MUDAL/Simple_Handwashing_System_With_STM32/Image.jpg

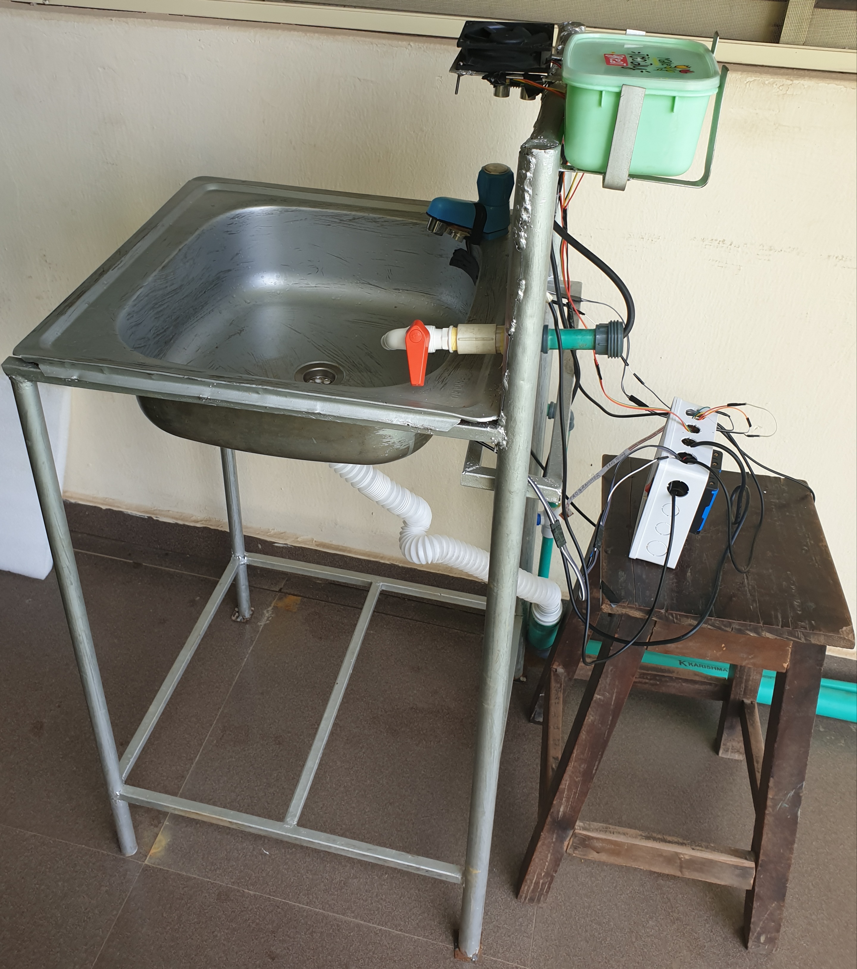
Image.jpg
