MUDAL/Simple_Handwashing_System_With_STM32/AHS Flowchart.pdf

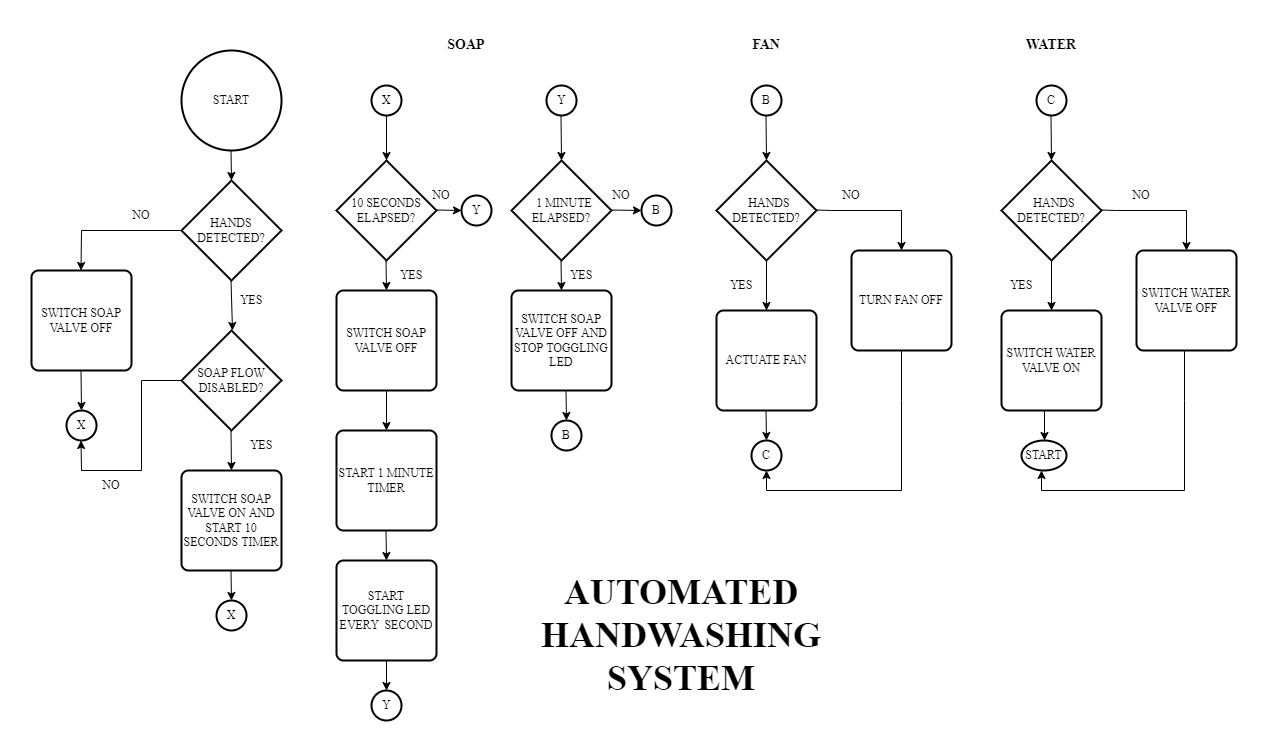
[picture p2: page 1]
