MUDAL/Simple_Handwashing_System_With_STM32/AHS Schematic.pdf

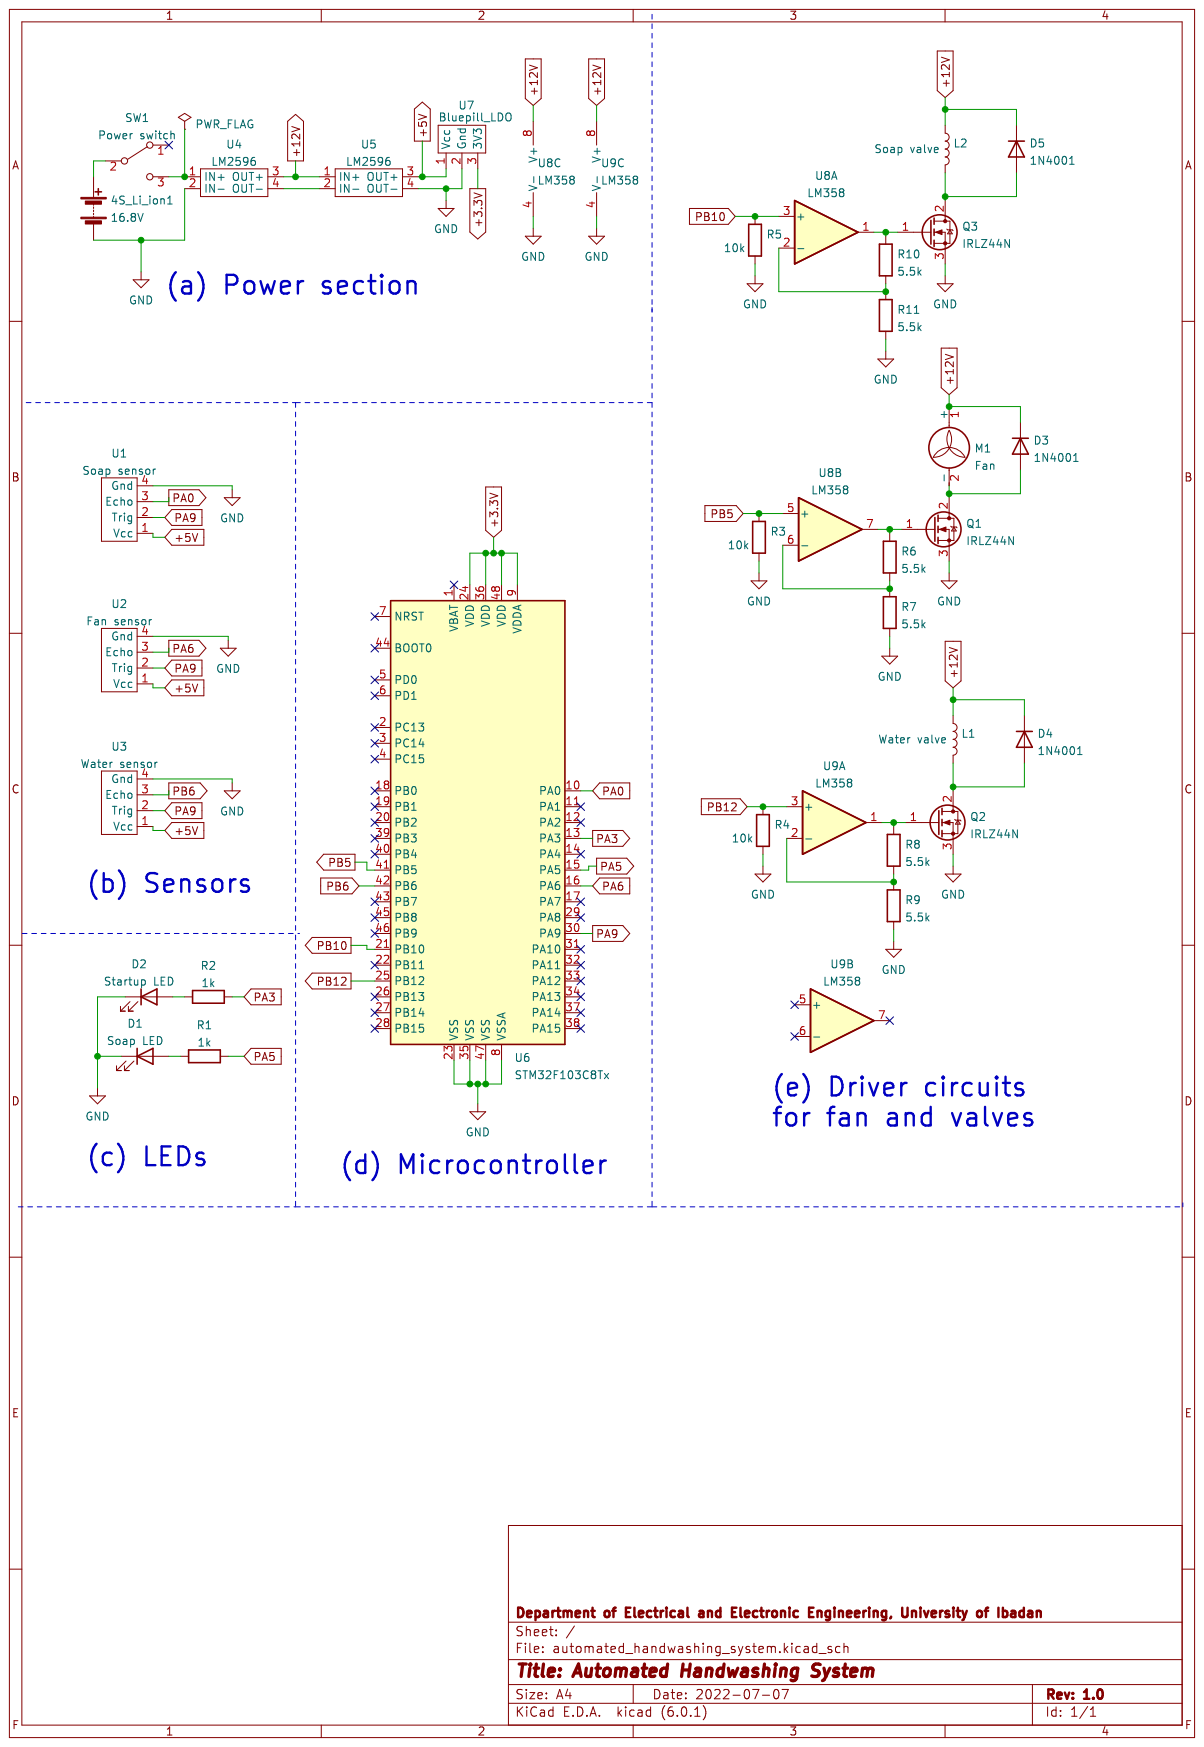
[picture p3: page 1]
