MUDAL/Simple_Handwashing_System_With_STM32/Source Code/Automated_Handwashing_System/Core/Src/main.c

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
/* Includes ------------------------------------------------------------------*/
#include "main.h"

/* USER CODE BEGIN Includes */
#include <stdbool.h>
#include "stm32f1xx_it.h"
/**
 * Important note
 * Timer 1 for all sensors (trigger pin)
 * Timer 2 for soap sensor
 * Timer 3 for fan sensor
 * Timer 4 for water sensor
 *
 * */

/* USER CODE END Includes */

/* USER CODE BEGIN PM */
//Equation: distance = pulse_width * echo_prescaler / (clkMHz * 58)
#define MAX_PULSE_WIDTH	 40 //8.6cm
/* USER CODE END PM */

 TIM_HandleTypeDef htim1;
TIM_HandleTypeDef htim2;
TIM_HandleTypeDef htim3;
TIM_HandleTypeDef htim4;

void SystemClock_Config(void);
static void MX_GPIO_Init(void);
static void MX_TIM1_Init(void);
static void MX_TIM2_Init(void);
static void MX_TIM3_Init(void);
static void MX_TIM4_Init(void);
/* USER CODE BEGIN 0 */
bool HandsDetected(TIM_HandleTypeDef* htim)
{
	uint32_t pulseWidth = 0;
	if((htim->Instance->SR & TIM_SR_CC2IF) == TIM_SR_CC2IF)
	{
		pulseWidth = htim->Instance->CCR2;
	}
	if(pulseWidth < MAX_PULSE_WIDTH)
	{
		return true;
	}
	return false;
}

/* USER CODE END 0 */

/**
  * @brief  The application entry point.
  * @retval int
  */
int main(void)
{
  /* USER CODE BEGIN 1 */
  //Variable(s)
  const uint32_t soapDispensationTime = 10000; //10 secs default
  const uint32_t soapValveShutOffTime = 60000; //1 minute default
  bool soapFlowDisabled = false;
  bool soapDispenseStarted = false;
  bool soapValveShutOff = false;
  bool firstTickMeasured = false;
  uint32_t currTick = 0; //current tick
  /* USER CODE END 1 */

  /* MCU Configuration--------------------------------------------------------*/

  /* Reset of all peripherals, Initializes the Flash interface and the Systick. */
  HAL_Init();

  /* Configure the system clock */
  SystemClock_Config();

  /* Initialize all configured peripherals */
  MX_GPIO_Init();
  MX_TIM1_Init();
  MX_TIM2_Init();
  MX_TIM3_Init();
  MX_TIM4_Init();
  /* USER CODE BEGIN 2 */
  //Indicate power on (turn power LED on for some seconds, then turn off)
  HAL_GPIO_WritePin(powerLED_GPIO_Port, powerLED_Pin, GPIO_PIN_SET);
  HAL_Delay(3000);
  HAL_GPIO_WritePin(powerLED_GPIO_Port, powerLED_Pin, GPIO_PIN_RESET);
  /* USER CODE END 2 */

  /* Infinite loop */
  /* USER CODE BEGIN WHILE */
  while (1)
  {
    /* USER CODE END WHILE */

    /* USER CODE BEGIN 3 */
	  HAL_Delay(500);
	  //Read soap sensor and actuate soap valve
	  if(HandsDetected(&htim2))
	  {
		  if(!soapFlowDisabled)
		  {
			  HAL_GPIO_WritePin(soapValve_GPIO_Port, soapValve_Pin, GPIO_PIN_SET);
			  soapDispenseStarted = true;
			  if(!firstTickMeasured)
			  {
				  currTick = HAL_GetTick();
				  firstTickMeasured = true;
			  }
		  }
	  }
	  else
	  {
		  HAL_GPIO_WritePin(soapValve_GPIO_Port, soapValve_Pin, GPIO_PIN_RESET);
	  }
	  //If soap dispensation time has elapsed, shut-off ..
	  //the soap valve and start blinking LED
	  if(soapDispenseStarted)
	  {
		  if((HAL_GetTick() - currTick) >= soapDispensationTime)
		  {
			  HAL_GPIO_WritePin(soapValve_GPIO_Port, soapValve_Pin, GPIO_PIN_RESET);
			  soapFlowDisabled = true;
			  soapValveShutOff = true;
			  soapDispenseStarted = false;
			  currTick = HAL_GetTick();
			  StartTogglingLED();
		  }
	  }
	  //If valve shut off time has elapsed, restore ....
	  //soap valve and sensor
	  if(soapValveShutOff)
	  {
		  if((HAL_GetTick() - currTick) >= soapValveShutOffTime)
		  {
			  soapValveShutOff = false;
			  soapFlowDisabled = false;
			  firstTickMeasured = false;
			  StopTogglingLED();
		  }
	  }

	  //Read fan sensor and actuate fan
	  if(HandsDetected(&htim3))
	  {
		 HAL_GPIO_WritePin(fan_GPIO_Port, fan_Pin, GPIO_PIN_SET);
	  }
	  else
	  {
		 HAL_GPIO_WritePin(fan_GPIO_Port, fan_Pin, GPIO_PIN_RESET);
	  }
	  //Read water sensor and actuate water valve
	  if(HandsDetected(&htim4))
	  {
		  HAL_GPIO_WritePin(waterValve_GPIO_Port, waterValve_Pin, GPIO_PIN_SET);
	  }
	  else
	  {
		  HAL_GPIO_WritePin(waterValve_GPIO_Port, waterValve_Pin, GPIO_PIN_RESET);
	  }
  }
  /* USER CODE END 3 */
}

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
