MUDAL/Simple_Handwashing_System_With_STM32/(commit log)

2022-07-16 Create Automated Handwashing System Schematic.pdf
2022-07-22 Create AHS Flowchart.pdf
2022-07-23 Update AHS Flowchart.pdf
2022-07-26 updated schematic
