MUDAL/Simple_Handwashing_System_With_STM32/(notices)

Notices in the files:
Source Code/Automated_Handwashing_System/Core/Src/main.c:
Copyright (c) 2022 STMicroelectronics.
All rights reserved.
This software is licensed under terms that can be found in the LICENSE file
